BleuLlama/ROMviz/Arduino/schematics/schem_EPROM.jpg

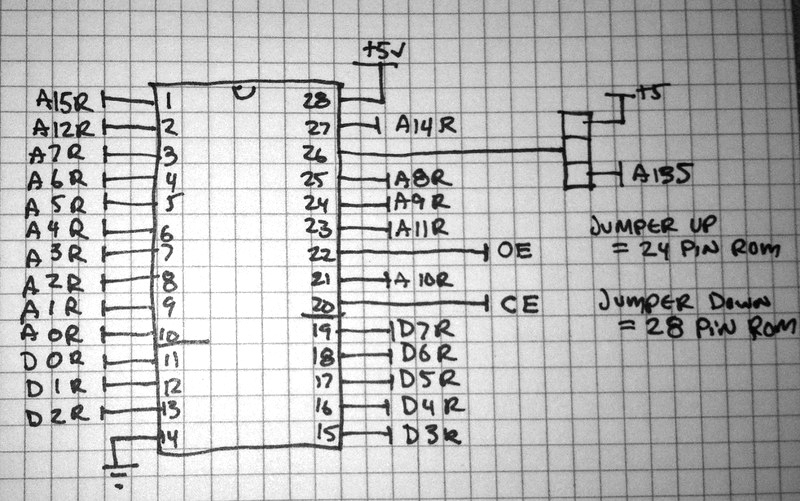
Arduino/schematics/schem_EPROM.jpg
