BleuLlama/ROMviz/Arduino/schematics/schem_74ls393_adders.jpg

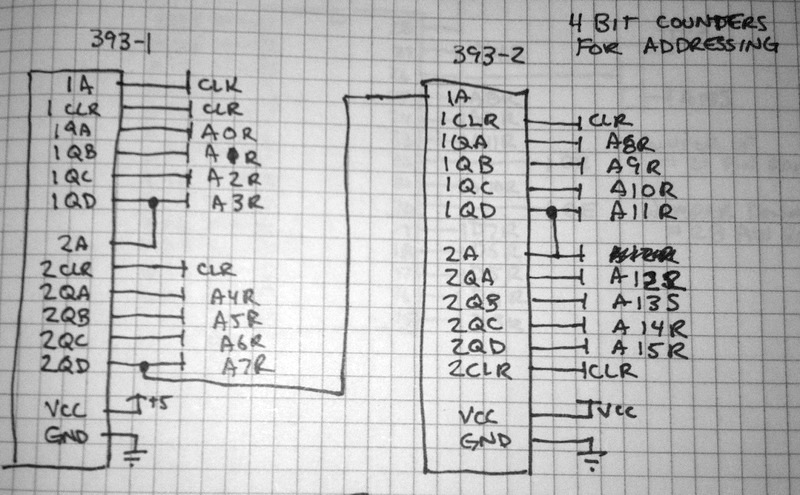
Arduino/schematics/schem_74ls393_adders.jpg
