BleuLlama/ROMviz/Arduino/schematics/schem_shield_interface.jpg

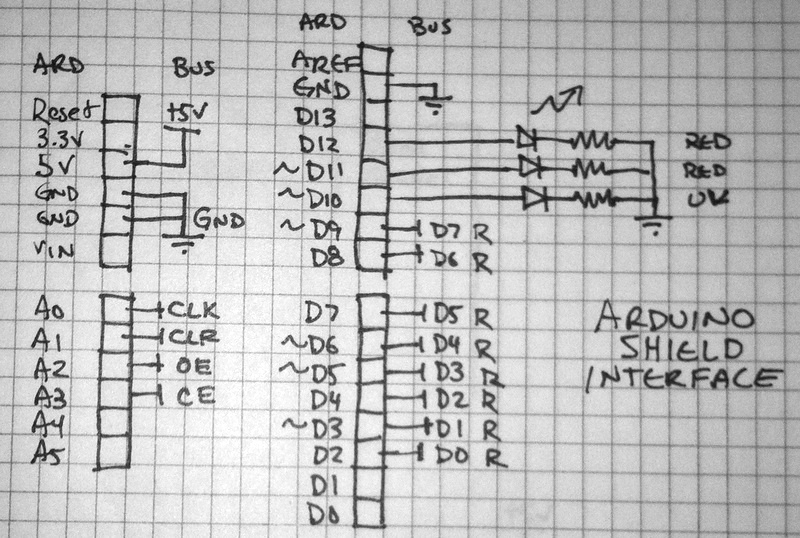
Arduino/schematics/schem_shield_interface.jpg
